lufixSch/effect-pedals/README.md

# effect-pedals
Circuits and PCB designs for audio effect pedals
