lufixSch/effect-pedals/distortion/BOM.xlsx

Sheet: rev3
Designator | Package | Distortion - Model/Value | Fuzz - Model/Value
U1 | SOT-23-5 | LMR62014XMF-NOPB | LMR62014XMF-NOPB
U2 | SOT-23-5 | TL081H | TL081H
U3 | SOT-23-5 | TL081H | TL081H
U4 | SOT-23-5 | TL081H | TL081H
U5 | SOT-23-5 | TLV767 | TLV767
U6 | SOT-23-5 | TL081H | TL081H
D1 | SOD-123 | 1N4148 | 1N4148
D2 | SOD-123 | 1N4148 | 1N4148
D3 | SOD-123 | 1N4148 | 1N4148
D4 | SOD-123 | 1N4148 | 1N4148
D5 | 0805-2012 | SD0805S020S1R0 | SD0805S020S1R0
D6 | PinHeader_1x2 | Red LED | Red LED
J1 | PinHeader_1x2 | 6.3mm Audio Jack | 6.3mm Audio Jack
J2 | PinHeader_1x2 | 6.3mm Audio Jack | 6.3mm Audio Jack
J3 | GCT_USB4125-GF-A-0190_REVA2 | USB4125-GF-A-0190 | USB4125-GF-A-0190
J4 | PinHeader_1x2 | 9V Barrel Jack | 9V Barrel Jack
JP1 | R_0805-2012 | 0Ω | 0Ω
JP2 | R_0805-2012 | 0Ω | 0Ω
JPF1 | R_0805-2012 | 0Ω | -
SW1 | PinHeader_2x3 | 6P DPDT Foot Switch | 6P DPDT Foot Switch
L1 | Abracon ASPI 3012S | 10uH | 10uH
Rcc1 | R_0805-2012 | 5.1k | 5.1k
Rcc2 | R_0805-2012 | 5.1k | 5.1k
Rcc3 | R_0805-2012 | 5.1k | 5.1k
Rcc4 | R_0805-2012 | 5.1k | 5.1k
Level1 | PinHeader_1x3 | 10k | 50k
Tone1 | PinHeader_1x3 | 10k | 10k
Gain1 | PinHeader_1x3 | 10k | 10k
R1 | R_0805-2012 | 100Ω | 1k
R2 | R_0805-2012 | 5.1k | 5.1k
R3 | R_0805-2012 | 10k | 10k
R4 | R_0805-2012 | 100k | 100k
R5 | R_0805-2012 | 0Ω | 0Ω
R6 | R_0805-2012 | 100Ω | 100Ω
R7 | R_0805-2012 | 2k | 2k
R8 | R_0805-2012 | 10k | 10k
R9 | R_0805-2012 | 0Ω | 100k
R10 | R_0805-2012 | 100k | 100k
R11 | R_0805-2012 | 13k | 13k
R12 | R_0805-2012 | 82k | 82k
R13 | R_0805-2012 | 300Ω | 300Ω
R14 | R_0805-2012 | 510k | 510k
R16 | R_0805-2012 | 510k | 510k
R18 | R_0805-2012 | 100k | 100k
RD1 | R_0805-2012 | 100Ω | -
RF1 | R_0805-2012 | - | 1k
RF2 | R_0805-2012 | - | 100k
C1 | C_0805-2012 | 470nF | 470nF
C2 | C_0805-2012 | 470nF | 470nF
C3 | C_0805-2012 | 2.2uF | 2.2uF
C4 | C_1206-3216 | 22uF | 22uF
C5 | C_0805-2012 | 330pF | 330pF
C6 | C_0805-2012 | 100nF | 100nF
C7 | C_0805-2012 | 10uF | 10uF
C8 | C_0805-2012 | 10uF | 10uF
C10 | C_0805-2012 | 20nF | 20nF
C11 | C_0805-2012 | 4.7uF | 4.7uF
C12 | C_1206-3216 | 22uF | 22uF
C13 | C_0805-2012 | 100nF | 100nF
C14 | C_0805-2012 | 10uF | 10uF
C15 | C_0805-2012 | 100nF | 100nF
C16 | C_0805-2012 | 10uF | 10uF
C17 | C_0805-2012 | 100nF | 100nF
C18 | C_0805-2012 | 10uF | 10uF

Sheet: rev2
Designator | Package | Distortion - Model/Value | Fuzz - Model/Value
U1 | SOT-23-5 | LMR62014XMF-NOPB | LMR62014XMF-NOPB
U2 | SOT-23-5 | TL081H | TL081H
U3 | SOT-23-5 | TL081H | TL081H
U4 | SOT-23-5 | TL081H | TL081H
U5 | SOT-23-5 | TLV767 | TLV767
U6 | SOT-23-5 | TL081H | TL081H
D1 | SOD-123 | 1N4148 | 1N4148
D2 | SOD-123 | 1N4148 | 1N4148
D3 | SOD-123 | 1N4148 | 1N4148
D4 | SOD-123 | 1N4148 | 1N4148
D5 | 0805-2012 | SD0805S020S1R0 | SD0805S020S1R0
D6 | PinHeader_1x2 | Red LED | Red LED
J1 | PinHeader_1x2 | 6.3mm Audio Jack | 6.3mm Audio Jack
J2 | PinHeader_1x2 | 6.3mm Audio Jack | 6.3mm Audio Jack
J3 | GCT_USB4125-GF-A-0190_REVA2 | USB4125-GF-A-0190 | USB4125-GF-A-0190
J4 | PinHeader_1x2 | 9V Barrel Jack | 9V Barrel Jack
JP1 | R_0805-2012 | 0Ω | 0Ω
JP2 | R_0805-2012 | 0Ω | 0Ω
JPF1 | R_0805-2012 | 0Ω | -
SW1 | PinHeader_2x3 | 6P DPDT Foot Switch | 6P DPDT Foot Switch
L1 | Abracon ASPI 3012S | 10uH | 10uH
Rcc1 | R_0805-2012 | 5.1k | 5.1k
Rcc2 | R_0805-2012 | 5.1k | 5.1k
Rcc3 | R_0805-2012 | 5.1k | 5.1k
Rcc4 | R_0805-2012 | 5.1k | 5.1k
Level1 | PinHeader_1x3 | 10k | 10k
Tone1 | PinHeader_1x3 | 10k | 10k
Gain1 | PinHeader_1x3 | 10k | 10k
R1 | R_0805-2012 | 1k | 1k
R2 | R_0805-2012 | 2k | 2k
R3 | R_0805-2012 | 10k | 10k
R4 | R_0805-2012 | 100k | 100k
R5 | R_0805-2012 | 0Ω | 0Ω
R6 | R_0805-2012 | 100Ω | 100Ω
R7 | R_0805-2012 | 1k | 1k
R8 | R_0805-2012 | 10k | 10k
R10 | R_0805-2012 | 100k | 100k
R11 | R_0805-2012 | 13k | 13k
R12 | R_0805-2012 | 82k | 82k
R13 | R_0805-2012 | 300Ω | 300Ω
R14 | R_0805-2012 | 510k | 510k
R16 | R_0805-2012 | 510k | 510k
RD1 | R_0805-2012 | 1k | -
RD3 | R_0805-2012 | 100k | -
RF1 | R_0805-2012 | - | 1k
C1 | C_0805-2012 | 470nF | 470nF
C2 | C_0805-2012 | 470nF | 470nF
C3 | C_0805-2012 | 2.2uF | 2.2uF
C4 | C_1206-3216 | 22uF | 22uF
C5 | C_0805-2012 | 330pF | 330pF
C6 | C_0805-2012 | 100nF | 100nF
C7 | C_0805-2012 | 10uF | 10uF
C8 | C_0805-2012 | 10uF | 10uF
C10 | C_0805-2012 | 39nF | 39nF
C11 | C_0805-2012 | 4.7uF | 4.7uF
C12 | C_1206-3216 | 22uF | 22uF
C13 | C_0805-2012 | 100nF | 100nF
C14 | C_0805-2012 | 10uF | 10uF
C15 | C_0805-2012 | 100nF | 100nF
C16 | C_0805-2012 | 10uF | 10uF
C17 | C_0805-2012 | 100nF | 100nF
C18 | C_0805-2012 | 10uF | 10uF
