lufixSch/effect-pedals/reverb/models/exciter_mount.FCStd

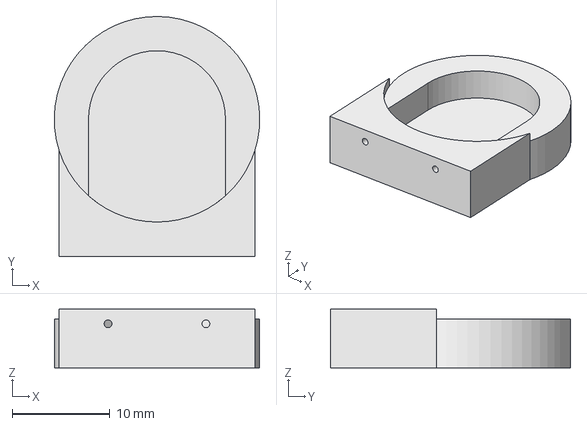
[picture p1: CAD file, 2023-02-13]
reverb/models/exciter_mount.FCStd
21.0 x 24.5 x 6.00 mm
