lufixSch/effect-pedals/reverb/models/spring_hook.FCStd

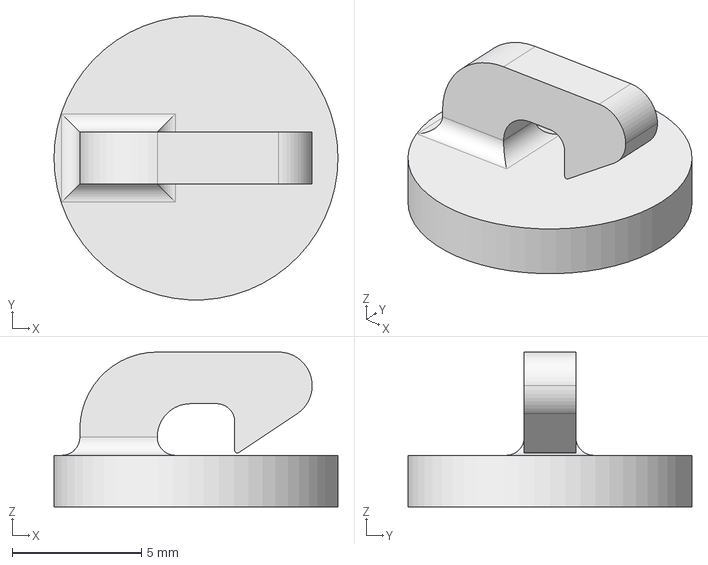
[picture p2: CAD file, 2023-02-13]
reverb/models/spring_hook.FCStd
11.0 x 11.0 x 6.00 mm
