lufixSch/effect-pedals/(list of files, cad)

Other CAD files:
reverb/models/exciter_mount.3mf
reverb/models/exciter_mount.stl
reverb/models/spring_hook.3mf
reverb/models/spring_hook.stl
