lufixSch/effect-pedals/simulations/distortion.asc

C1: cap; 50n
C2: cap; 50n
C3: cap; 10µ
C4: cap; 10µ
C5: cap; 330n
C6: cap; 22µ
C7: cap; 22µ
D1: diode
D2: diode
D3: diode
D4: diode
D5: diode
Q1: npn
Q2: pnp
Q3: npn
Q4: npn
Q5: npn
Q6: pnp
Q7: npn
Q8: npn
R1: res; 3.3k
R2: res; 10k
R3: res; 1k
R4: res; 8k
R5: res; 8k
R6: res; 10k
R7: res; 12k
R8: res; 1k
R9: res; 5k
R10: res; 1k
R11: res; 1k
R12: res; 1k
R13: res; 2.5k
R14: res; 2.5k
R15: res; 50k
R16: res; 1k
R17: res; 1k
R18: res; 1k
R19: res; 5k
R20: res; 2k
R21: res; 100
R22: res; 100k
R23: res; 100k
R25: res; 360k
R26: res; 360k
R27: res; 360k
U1: OP07
U2: OP07
U3: OP07
U4: OP07
U5: OP07
V1: voltage; 9
V2: signal; SINE(0 2 1K)
V3: voltage; 9
V4: signal; SINE(0 15 1K)
V5: voltage; 3.3
V6: signal
V7: signal; SINE(0 3 1k)
Named nets: VCC, 0, VEE, 3V3
.tran 10m
