lufixSch/effect-pedals/simulations/fuzz.asc

C1: cap; 50n
C2: cap; 22µ
C3: cap; 22µ
C4: cap; 22µ
C5: cap; 22µ
C6: cap; 22µ
C7: cap; 22µ
C8: cap; 22µ
C9: cap; 22µ
C10: cap; 100n
C11: cap; 22µ
D1: diode; 1N4148
D2: diode; 1N4148
D3: diode; 1N4148
D4: diode; 1N4148
D5: diode; 1N4148
D6: diode; 1N4148
D7: diode; 1N4148
D8: diode; 1N4148
D9: diode; 1N4148
R1: res; 1k
R2: res; 51k
R3: res; 1k
R4: res; 20k
R5: res; 1k
R6: res; 1k
R7: res; 50k
R8: res; 510k
R9: res; 510k
R10: res; 100k
R11: res; 1k
R12: res; 1k
R13: res; 20k
R14: res; 10k
R15: res; 100k
R16: res; 1k
R17: res; 510k
R18: res; 510k
R19: res; 50k
R20: res; 510k
R21: res; 510k
R22: res; 1k
R23: res; 50k
R24: res; 1k
U1: OP07
U2: OP07
U3: OP07
U4: OP07
U5: OP07
U6: OP07
U7: OP07
U8: OP07
V1: voltage; 9
V2: signal
V3: voltage; 8
V4: signal
V5: signal; SINE(0 2 1K)
V6: signal; SINE(0 500m 2k)
V7: signal; PULSE(-1 1 0 1n 1n 0.5m 1m)
Named nets: VCC, 0, VEE, VGND
.tran 10m
