lufixSch/effect-pedals/simulations/tone_treble.asc

C1: cap; 40n
C2: cap; 20n
C3: cap; 560p
C4: cap; 47n
C5: cap; 47n
C6: cap; 1n
R1: res; 5k
R2: res; 1k
R3: res; 5k
R4: res; 1k
R5: res; 30k
R6: res; 90k
R7: res; 22k
R8: res; 22k
R9: res; 22k
R10: res; 50k
R11: res; 50k
R12: res; 20k
R13: res; 80k
R14: res; 10k
R15: res; 10k
R16: res; 50k
R17: res; 50k
R18: res; 10k
U1: OP07
U2: OP07
U3: OP07
U4: OP07
V1: voltage; 9
V2: voltage; 9
V3: signal; SINE(0 2 1K); AC 2
V4: signal; SINE(0 2 1K); AC 2
V5: signal; SINE(0 2 1K); AC 2
V6: signal; SINE(0 2 1K); AC 2
Named nets: VCC, VEE, 0
.ac dec 20 10 100k
