lufixSch/effect-pedals/simulations/wavefolding.asc

Q1: npn
Q2: pnp
R1: res; 20k
R2: res; 20k
V1: signal; SINE(0 100m 1k 0 0 0 0)
V3: voltage; 9
V4: voltage; 9
Named nets: 0, VCC, VEE
.tran 10m
