lufixSch/effect-pedals/simulations/trebble.asc

C1: cap; 50n
C4: cap; 10n
R2: res; 5k
R4: res; 1k
R5: res; 5k
R8: res; 1k
R10: res; 1k
R14: res; 1k
U1: OP07
U2: OP07
V1: voltage; 9
V2: voltage; 9
V3: signal; PULSE(-1 1 0 1u 1u 500u 1m); AC 1 0
V4: signal; PULSE(-1 1 0 1u 1u 500u 1m); AC 1 0
Named nets: VCC, 0, VEE
.tran 10m
#.ac dec 20 10 100k
