lufixSch/effect-pedals/simulations/mixer.asc

R1: res; 1k
R2: res; 1k
R3: res; 1k
R4: res; 10k
U1: OP07
V1: signal; SINE(0 0.1 5K)
V2: voltage; 9
V3: signal
V4: voltage; 9
Named nets: 0, VCC, VEE
.tran 10m
