lufixSch/effect-pedals/distortion/pcb/distortion-pedal.kicad_pcb

## KiCad design distortion/pcb/distortion-pedal.kicad_pcb (2023-02-13)

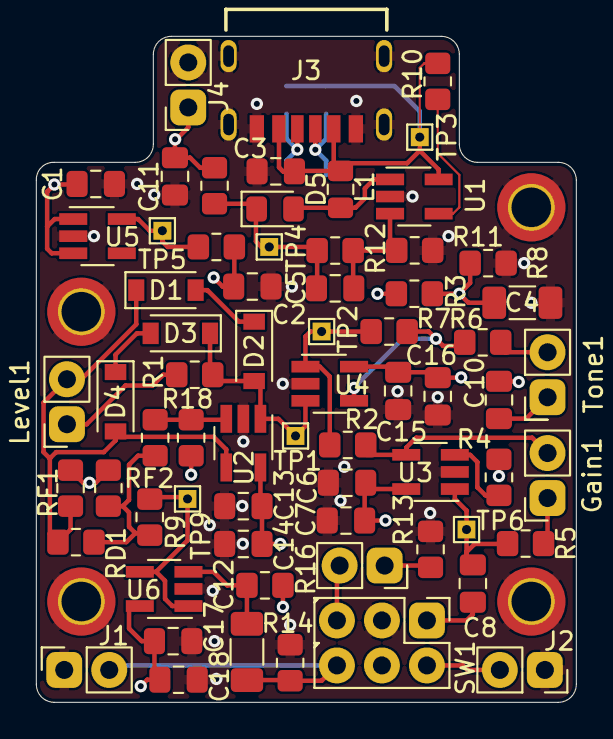
[picture p3: board distortion-pedal.kicad_pcb from above]

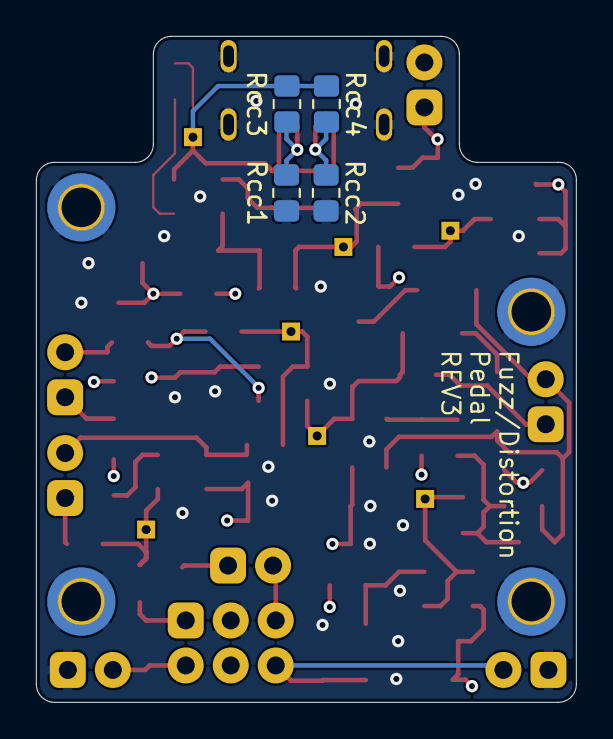
[picture p4: board distortion-pedal.kicad_pcb from below]

Board: 4 copper layers, 30.0 x 37.0 mm, 75 parts (4 on the bottom side), 34 nets.

Parts:
C1, C2: 0.47uF; C_0805_2012Metric_Pad1.18x1.45mm_HandSolder
C3: 2.2uF; C_0805_2012Metric_Pad1.18x1.45mm_HandSolder
C4: 33uF; C_1206_3216Metric_Pad1.33x1.80mm_HandSolder
C5: 330pF; C_0805_2012Metric_Pad1.18x1.45mm_HandSolder
C6, C13, C15, C17: 100nF; C_0805_2012Metric_Pad1.18x1.45mm_HandSolder
C7, C10, C14, C16, C18: 10uF; C_0805_2012Metric_Pad1.18x1.45mm_HandSolder
C8: C; C_0805_2012Metric_Pad1.18x1.45mm_HandSolder
C11: 4.7uF; C_0805_2012Metric_Pad1.18x1.45mm_HandSolder
C12: 22uF; C_1206_3216Metric_Pad1.33x1.80mm_HandSolder
D1, D2, D3, D4: 1N4148; D_SOD-123
D5: SD0805S020S1R0; D_0805_2012Metric_Pad1.15x1.40mm_HandSolder
D6: LED; led_wired_1_pin
Gain1: 10k; potentiometer_wired_23_connected
H1, H2, H3, H4: MountingHole_Pad; MountingHole_2.2mm_M2_DIN965_Pad_TopBottom
J1, J2: AudioJack2_Ground; audio_jack_wired
J3: USB4125-GF-A-0190; GCT_USB4125-GF-A-0190_REVA2
J4: Barrel_Jack; barrel_jack_wired
JP1, JP2: Jumper_2_Open; R_0805_2012Metric_Pad1.20x1.40mm_HandSolder
JPF1: Jumper_2_Open; R_0805_2012Metric_Pad1.20x1.40mm_HandSolder
L1: 10uH; L_0805_2012Metric_Pad1.15x1.40mm_HandSolder
Level1: R; potentiometer_wired_23_connected
R1, R2, R4, R5, R6, R7, R9, R18: R; R_0805_2012Metric_Pad1.20x1.40mm_HandSolder
R3, R8: 10k; R_0805_2012Metric_Pad1.20x1.40mm_HandSolder
R10: 100k; R_0805_2012Metric_Pad1.20x1.40mm_HandSolder
R11: 13k; R_0805_2012Metric_Pad1.20x1.40mm_HandSolder
R12: 82k; R_0805_2012Metric_Pad1.20x1.40mm_HandSolder
R13: 300; R_0805_2012Metric_Pad1.20x1.40mm_HandSolder
R14, R16: 510k; R_0805_2012Metric_Pad1.20x1.40mm_HandSolder
RD1: R; R_0805_2012Metric_Pad1.20x1.40mm_HandSolder
RF1, RF2: R; R_0805_2012Metric_Pad1.20x1.40mm_HandSolder
Rcc1, Rcc2, Rcc3, Rcc4: 5.1k; R_0805_2012Metric_Pad1.20x1.40mm_HandSolder
SW1: SW_DPDT_x2; switch_wired
TP1, TP2, TP3, TP4, TP5, TP6, TP9: TestPoint; TestPoint_THTPad_1.0x1.0mm_Drill0.5mm
Tone1: R; potentiometer_wired_12_connected
U1: LMR62014XMF-NOPB; SOT-23-5_HandSoldering
U2, U3, U4, U6: TL081H; SOT-23-5_HandSoldering
U5: TLV767; SOT-23-5_HandSoldering

Connections:
+4V: C4.1, C10.2, R3.1, R4.2, R8.2, R16.2, R18.2, RF1.2, RF2.1
+5V: C3.1, J3.A9 (VBUS), J3.B9 (VBUS), L1.1, R10.1, Rcc3.1, Rcc4.1, TP3.1, U1.5 (VIN)
+8V: C2.1, C6.1, C7.1, C13.1, C14.1, C15.1, C16.1, C17.1, C18.1, JP2.2 (B), R3.2, SW1.4, U2.5 (V+), U3.5 (V+), U4.5 (V+), U6.5 (V+)
+9V: C1.1, C11.1, J4.1, JP1.2 (B), U5.1 (IN), U5.3 (EN)
GND: C1.2, C2.2, C3.2, C4.2, C6.2, C7.2, C11.2, C13.2, C14.2, C15.2, C16.2, C17.2, C18.2, H1.1, H2.1, H3.1, H4.1, J1.1, J2.1, J3.A12 (GND), J3.B12 (GND), J3.S1 (SHIELD), J3.S2 (SHIELD), J3.S3 (SHIELD), J3.S4 (SHIELD), J4.2, R8.1, R11.2, R13.2, R14.2, Rcc1.2, Rcc2.2, SW1.6, U1.2 (GND), U2.2 (V-), U3.2 (V-), U4.2 (V-), U5.2 (GND), U6.2 (V-)
unnamed: C5.1, R11.1, R12.1, U1.3 (FB)
unnamed: C5.2, D5.1 (K), JP1.1 (A), R12.2, TP4.1
unnamed: C8.1, R5.1, TP6.1, U3.1 (OUT)
unnamed: C10.1, Tone1.1, Tone1.2
unnamed: C12.2, R16.1, U6.3 (+IN)
unnamed: D1.1 (K), D4.2 (A), Level1.2, Level1.3, RD1.2, RF1.1, U2.4 (-IN)
unnamed: D1.2 (A), D2.1 (K)
unnamed: D2.2 (A), D3.1 (K), R1.2, TP1.1, U2.1 (OUT), U4.3 (+IN)
unnamed: D3.2 (A), D4.1 (K)
unnamed: D5.2 (A), L1.2, U1.1 (SW)
unnamed: D6.1 (K), R13.1
unnamed: D6.2 (A), SW1.5
unnamed: Gain1.1, R5.2
unnamed: Gain1.2, Gain1.3, R2.1, U3.4 (-IN)
unnamed: J2.2, SW1.2
unnamed: J3.A5 (CC1), Rcc1.1, Rcc3.2
unnamed: J3.B5 (CC2), Rcc2.1, Rcc4.2
unnamed: JP2.1 (A), TP5.1, U5.5 (OUT)
unnamed: JPF1.1 (A), R9.1, RD1.1, RF2.2
unnamed: JPF1.2 (B), R18.1, U2.3 (+IN)
unnamed: Level1.1, R1.1
unnamed: R4.1, U3.3 (+IN)
unnamed: R6.1, Tone1.3
unnamed: R6.2, R7.1, U4.4 (-IN)
unnamed: R10.2, U1.4 (SHDN)
audio_in: C12.1, J1.2, R14.1, SW1.3
effect_in: R9.2, TP9.1, U6.1 (OUT), U6.4 (-IN)
effect_out: R2.2, R7.2, TP2.1, U4.1 (OUT)
gain_out: C8.2, SW1.1
