lufixSch/effect-pedals/global/circuit/gain_stage.kicad_sch

## KiCad design global/circuit/gain_stage.kicad_sch (2023-02-13)

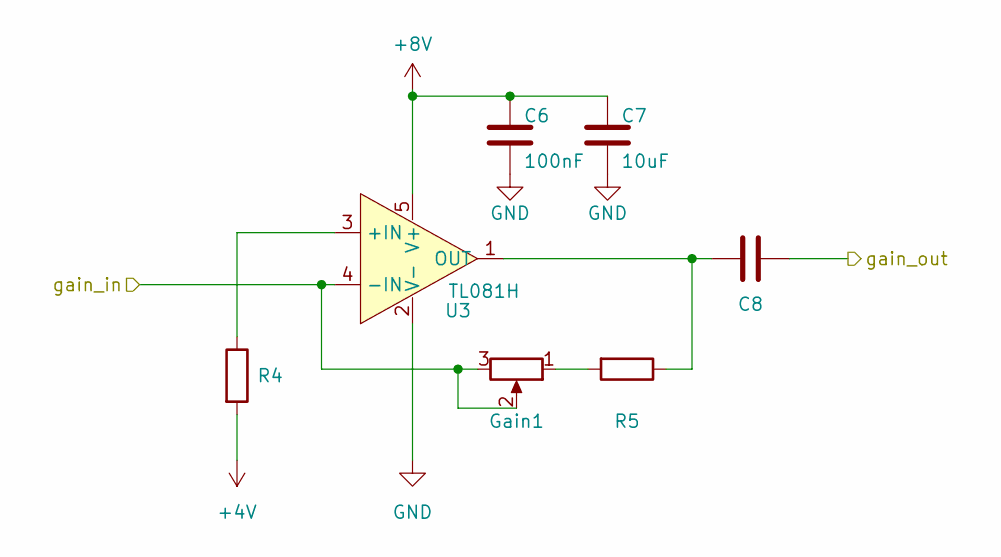
[picture p5: schematic gain_stage.kicad_sch]

Parts:
C6: 100nF; C_0805_2012Metric_Pad1.18x1.45mm_HandSolder
C7: 10uF; C_0805_2012Metric_Pad1.18x1.45mm_HandSolder
C8: C; C_0805_2012Metric_Pad1.18x1.45mm_HandSolder
Gain1: 10k; potentiometer_wired_23_connected
R4, R5: R; R_0805_2012Metric_Pad1.20x1.40mm_HandSolder
U3: TL081H; SOT-23-5_HandSoldering

Connections:
+4V: R4.2
+8V: C6.1, C7.1, U3.5 (V+)
GND: C6.2, C7.2, U3.2 (V-)
unnamed: C8.1, R5.1, U3.1 (OUT)
unnamed: Gain1.1, R5.2
unnamed: R4.1, U3.3 (+IN)
gain_in: Gain1.2, Gain1.3, U3.4 (-IN)
gain_out: C8.2
