lufixSch/effect-pedals/global/circuit/input_stage.kicad_sch

## KiCad design global/circuit/input_stage.kicad_sch (2023-02-13)

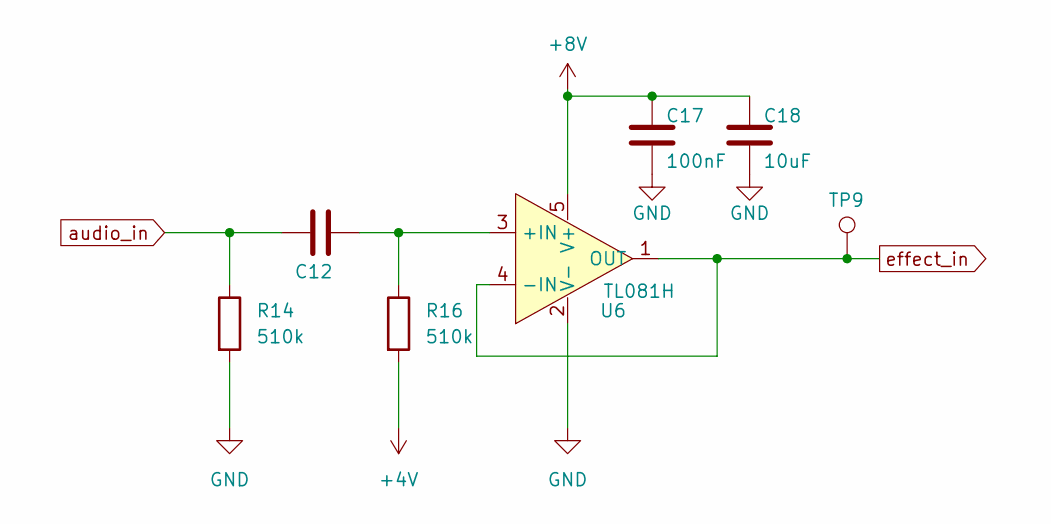
[picture p6: schematic input_stage.kicad_sch]

Parts:
C12: 22uF; C_1206_3216Metric_Pad1.33x1.80mm_HandSolder
C17: 100nF; C_0805_2012Metric_Pad1.18x1.45mm_HandSolder
C18: 10uF; C_0805_2012Metric_Pad1.18x1.45mm_HandSolder
R14, R16: 510k; R_0805_2012Metric_Pad1.20x1.40mm_HandSolder
TP9: TestPoint; TestPoint_THTPad_1.0x1.0mm_Drill0.5mm
U6: TL081H; SOT-23-5_HandSoldering

Connections:
+4V: R16.2
+8V: C17.1, C18.1, U6.5 (V+)
GND: C17.2, C18.2, R14.2, U6.2 (V-)
unnamed: C12.2, R16.1, U6.3 (+IN)
audio_in: C12.1, R14.1
effect_in: TP9.1, U6.1 (OUT), U6.4 (-IN)
