lufixSch/effect-pedals/global/circuit/io.kicad_sch

## KiCad design global/circuit/io.kicad_sch (2023-02-13)

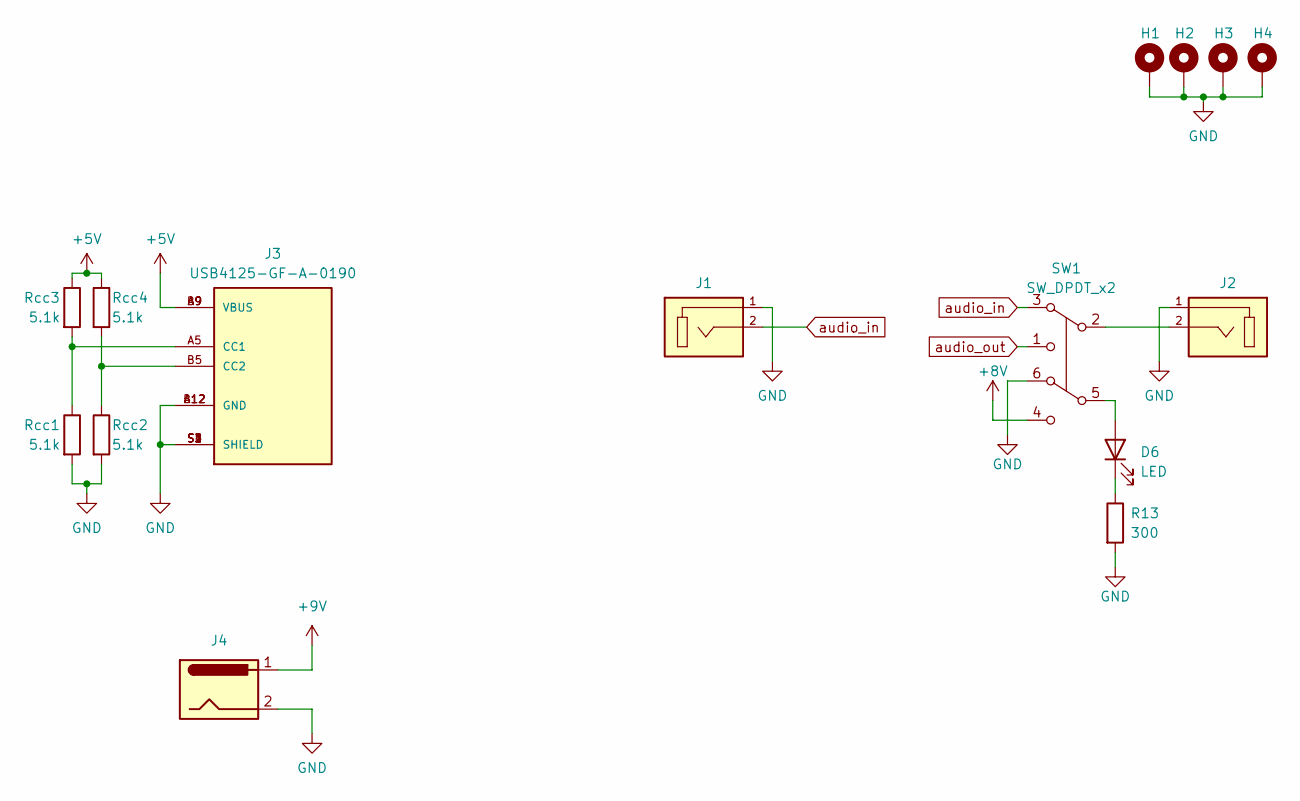
[picture p7: schematic io.kicad_sch]

Parts:
D6: LED; led_wired_1_pin
H1, H2, H3, H4: MountingHole_Pad; MountingHole_2.2mm_M2_DIN965_Pad_TopBottom
J1: AudioJack2_Ground; audio_jack_wired; Mouser Part Number 490-SJ-3523-SMT-TR
J2: AudioJack2_Ground; audio_jack_wired_shield_only; Mouser Part Number 490-SJ-3523-SMT-TR
J3: USB4125-GF-A-0190; GCT_USB4125-GF-A-0190_REVA2; Mouser Part Number 640-USB4125-GF-A-190
J4: Barrel_Jack; PinHeader_1x02_P2.54mm_Vertical
R13: 300; R_0805_2012Metric_Pad1.20x1.40mm_HandSolder
Rcc1, Rcc2, Rcc3, Rcc4: 5.1k; R_0805_2012Metric_Pad1.20x1.40mm_HandSolder
SW1: SW_DPDT_x2; switch_wired_reduced; Mouser Part Number 107-SF12011F-L

Connections:
+5V: J3.A9 (VBUS), J3.B9 (VBUS), Rcc3.1, Rcc4.1
+8V: SW1.4
+9V: J4.1
GND: H1.1, H2.1, H3.1, H4.1, J1.1, J2.1, J3.A12 (GND), J3.B12 (GND), J3.S1 (SHIELD), J3.S2 (SHIELD), J3.S3 (SHIELD), J3.S4 (SHIELD), J4.2, R13.2, Rcc1.2, Rcc2.2, SW1.6
unnamed: D6.1 (K), R13.1
unnamed: D6.2 (A), SW1.5
unnamed: J2.2, SW1.2
unnamed: J3.A5 (CC1), Rcc1.1, Rcc3.2
unnamed: J3.B5 (CC2), Rcc2.1, Rcc4.2
audio_in: J1.2, SW1.3
audio_out: SW1.1
