lufixSch/effect-pedals/global/circuit/power_supply.kicad_sch

## KiCad design global/circuit/power_supply.kicad_sch (2023-02-13)

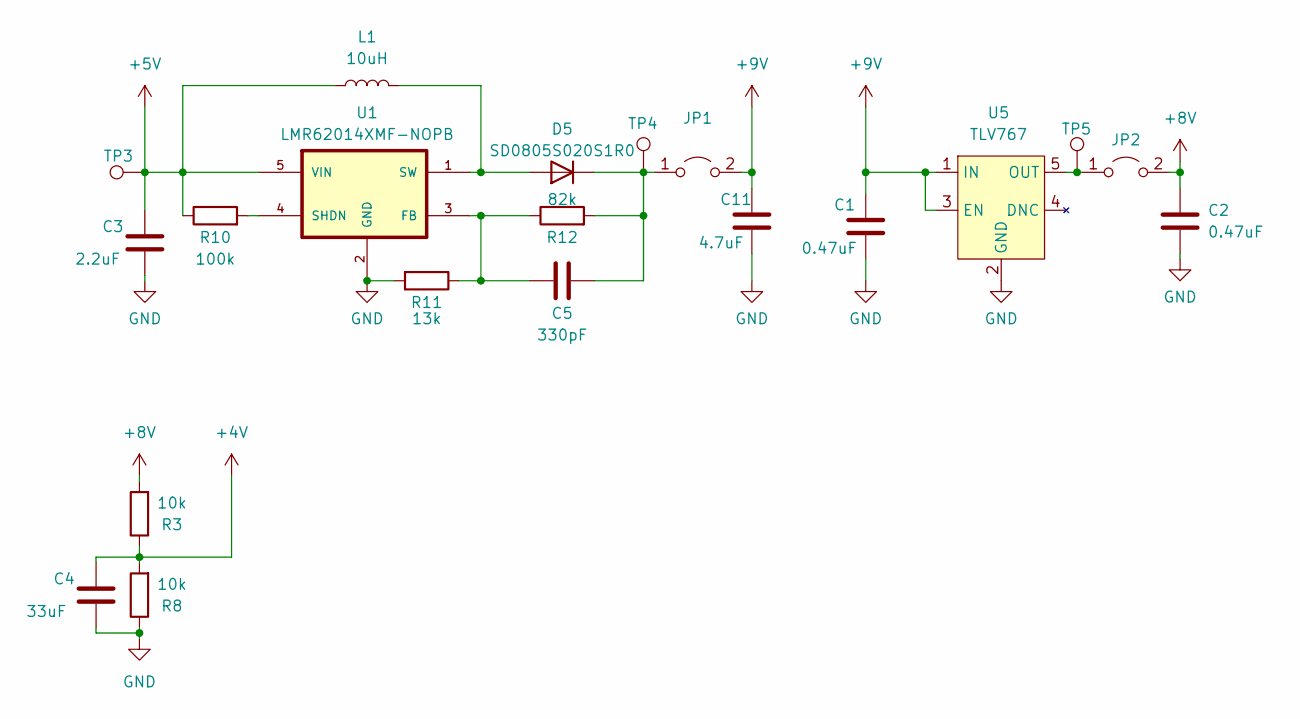
[picture p8: schematic power_supply.kicad_sch]

Parts:
C1, C2: 0.47uF; C_0805_2012Metric_Pad1.18x1.45mm_HandSolder
C3: 2.2uF; C_0805_2012Metric_Pad1.18x1.45mm_HandSolder
C4: 33uF; C_1206_3216Metric_Pad1.33x1.80mm_HandSolder
C5: 330pF; C_0805_2012Metric_Pad1.18x1.45mm_HandSolder
C11: 4.7uF; C_0805_2012Metric_Pad1.18x1.45mm_HandSolder
D5: SD0805S020S1R0; D_0805_2012Metric_Pad1.15x1.40mm_HandSolder
JP1, JP2: Jumper_2_Open; R_0805_2012Metric_Pad1.20x1.40mm_HandSolder
L1: 10uH; L_Abracon_ASPI-3012S
R3, R8: 10k; R_0805_2012Metric_Pad1.20x1.40mm_HandSolder
R10: 100k; R_0805_2012Metric_Pad1.20x1.40mm_HandSolder
R11: 13k; R_0805_2012Metric_Pad1.20x1.40mm_HandSolder
R12: 82k; R_0805_2012Metric_Pad1.20x1.40mm_HandSolder
TP3, TP4, TP5: TestPoint; TestPoint_THTPad_1.0x1.0mm_Drill0.5mm
U1: LMR62014XMF-NOPB; SOT-23-5_HandSoldering
U5: TLV767; SOT-23-5_HandSoldering

Connections:
+4V: C4.1, R3.1, R8.2
+5V: C3.1, L1.1, R10.1, TP3.1, U1.5 (VIN)
+8V: C2.1, JP2.2 (B), R3.2
+9V: C1.1, C11.1, JP1.2 (B), U5.1 (IN), U5.3 (EN)
GND: C1.2, C2.2, C3.2, C4.2, C11.2, R8.1, R11.2, U1.2 (GND), U5.2 (GND)
unnamed: C5.1, R11.1, R12.1, U1.3 (FB)
unnamed: C5.2, D5.1 (K), JP1.1 (A), R12.2, TP4.1
unnamed: D5.2 (A), L1.2, U1.1 (SW)
unnamed: JP2.1 (A), TP5.1, U5.5 (OUT)
unnamed: R10.2, U1.4 (SHDN)
