lufixSch/effect-pedals/(commit log)

2022-10-23 add basic distortion pedal
    [distortion-pedal.kicad_pcb, distortion-pedal.kicad_sch, gain_stage.kicad_sch, io.kicad_sch, power_supply.kicad_sch]
2022-10-24 add circuit dimensioning
    [distortion-pedal.kicad_pcb, distortion-pedal.kicad_sch, gain_stage.kicad_sch]
2022-10-25 add BOM, rework dimensioning
    [BOM.xlsx, distortion-pedal.csv, distortion-pedal.kicad_sch]
2022-11-06 rework distortion circuit and simulations
    [distortion-pedal.kicad_pcb, distortion-pedal.kicad_sch, input_stage.kicad_sch, io.kicad_sch, power_supply.kicad_sch]
2022-11-07 create gerber files, update BOM for REV2
    [BOM.xlsx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]
2022-12-13 distortion rev 3
    [distortion-pedal.kicad_pcb, distortion-pedal.kicad_sch, gain_stage.kicad_sch, io.kicad_sch]
2022-12-20 distortion pedal REV3 Gerber files
    [distortion-pedal-B_Mask.gbr, distortion-pedal-B_Paste.gbr, distortion-pedal-B_Silkscreen.gbr, distortion-pedal-Back.gbr, distortion-pedal-Edge_Cuts.gbr, distortion-pedal-F_Mask.gbr, distortion-pedal-F_Paste.gbr, distortion-pedal-F_Silkscreen.gbr]
2022-12-20 add reverb circuit
    [reverb-pedal.kicad_pcb, reverb-pedal.kicad_sch]
2022-12-20 rework global circuits
    [gain_stage.kicad_sch, input_stage.kicad_sch, io.kicad_sch, power_supply.kicad_sch]
2022-12-20 fix project error
    [distortion-pedal.kicad_pcb]
2023-01-03 minor circuit rework for better use with multiple projects
    [distortion-pedal.csv, distortion-pedal.kicad_pcb, distortion-pedal.kicad_sch, gain_stage.kicad_sch, input_stage.kicad_sch, io.kicad_sch, power_supply.kicad_sch]
2023-01-04 update BOM
    [BOM.xlsx, distortion-pedal.kicad_pcb]
2023-01-04 add models for spring reverb
    [exciter_mount.3mf, exciter_mount.FCStd, spring_hook.3mf, spring_hook.FCStd]
2023-02-13 update to KiCad 7.0
    [distortion-pedal.csv, distortion-pedal.kicad_pcb, distortion-pedal.kicad_sch, exciter_mount.FCStd, exciter_mount.stl, gain_stage.kicad_sch, input_stage.kicad_sch, io.kicad_sch]
